JadeColine/Le-pot-de-fleur-intelligent/README.md

# Le-pot-de-fleur-intelligent
Notre projet consiste en un pot de fleur connecté commandable à distance.
