JadeColine/Le-pot-de-fleur-intelligent/Rapports séances/JadeColine.md

Ce répertoire contient nos rapports de séances individuels pour notre projet Arduino.
