JadeColine/Le-pot-de-fleur-intelligent/Rapports séances/Rapport_séance8_EVRARD.docx

EVRARD JADE PEIP2 GR3

Projet : Le pot-de-fleur intelligent

RAPPORT SEANCE 8 : 02/03/2020

- Vérification des branchements et arrangements

Lors de cette séance, j’ai tout d’abord commencé par effectuer une vérification de tous nos branchements. Je me suis alors rendu compte d’un fil connecté à la pompe était mal branché car l’extrémité de son fil ne tenait pas dans l’emplacement à vis, j’ai donc du resouder ce fil afin qu’il tienne correctement.

- Dispositif pour LED

Je me suis ensuite occupée du morceau en plastique qui va servir à tenir nos LED. Je l’ai recollé de façon à ce qu’il soit au-dessus des plantes grâce au pistocolle. Cependant, quelques heures plus tard, le montage est à nouveau tombé. On a donc décidé d’acheter de la super glue et on a ensuite recollé tout le dispositif.

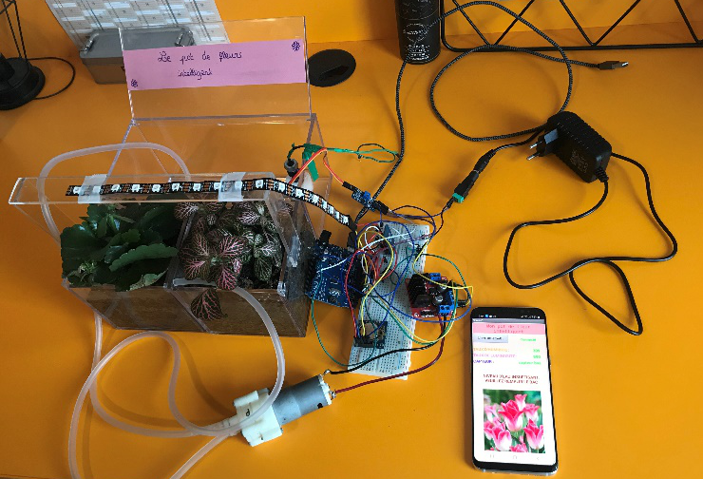
[picture p33: figure]

- Test final

Finalement, il nous restait plus qu’à tester tout notre projet assemblé avec toutes les propriétés que nous avons mis en place.

En ce qui concerne l’application, elle fonctionne et s’actualise en temps et en heure en fonction des données que l’on reçoit par Bluetooth grâce aux capteurs qui sont disposés dans la terre de notre plante (humidité), à côté de celle-ci (luminosité) et dans le bac d’eau (capteur de niveau d’eau). Il restera cependant à prendre une photo de nos plantes pour mettre sur l’application à la place de la photo de fleurs qui y est actuellement. Cette photo permettra de personnaliser notre projet.

Pour la pompe, elle fonctionne comme souhaité selon les besoins de notre plante, c’est-à-dire en fonction de son taux d’humidité. La pompe s’active lorsque le taux d’humidité est inférieur au seuil souhaité que l’on a fixé (il s’agit de la valeur 150). La pompe aspire l’eau qui se trouve dans le bac d’eau et arrose nos plantes grâce à celle-ci, elle est active pendant 3 secondes. Cet intervalle de temps permet au capteur d’humidité de réajuster sa valeur en fonction de l’eau que la plante viendra de recevoir et ainsi de connaître les nouveaux besoins de notre plante.

Le capteur de niveau d’eau est toujours en parfait fonctionnement et on a bien l’indication sur l’application lorsqu’il y a une insuffisance d’eau et que l’utilisateur doit remplir le bac.

Enfin, concernant le capteur de luminosité nous avons encore un problème au niveau de l’allumage des LED avec le module RTC. Nous sommes en train de le régler à l’aide de tests qui nous permettent de savoir d’où proviennent nos erreurs dans les différentes boucles de notre programme.
